Georgebruh/Vantage-System-for-ANDAM/outputs/power-board/Vantage_Power_Envelope.pdf

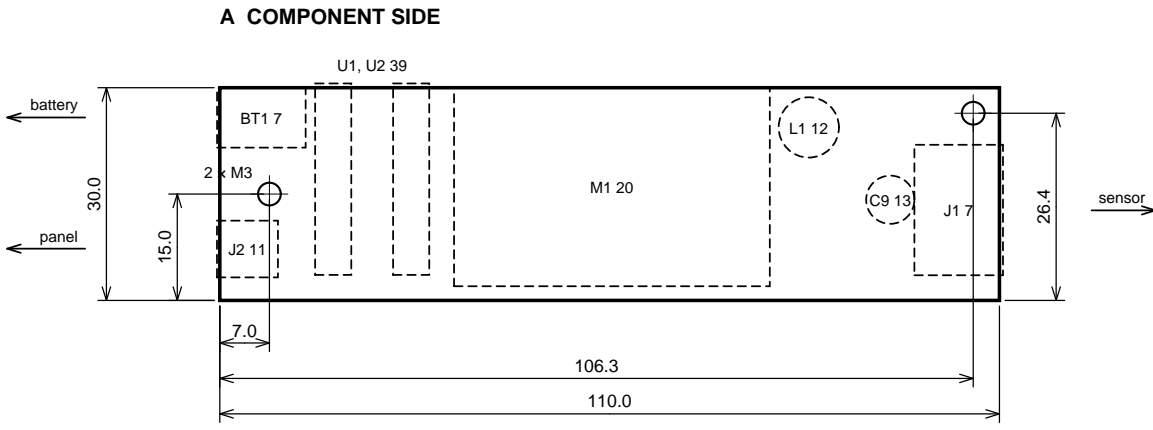
[picture p1: figure]
A COMPONENT SIDE; battery; panel; sensor

C END VIEW, SMALLEST ROUND TUBE

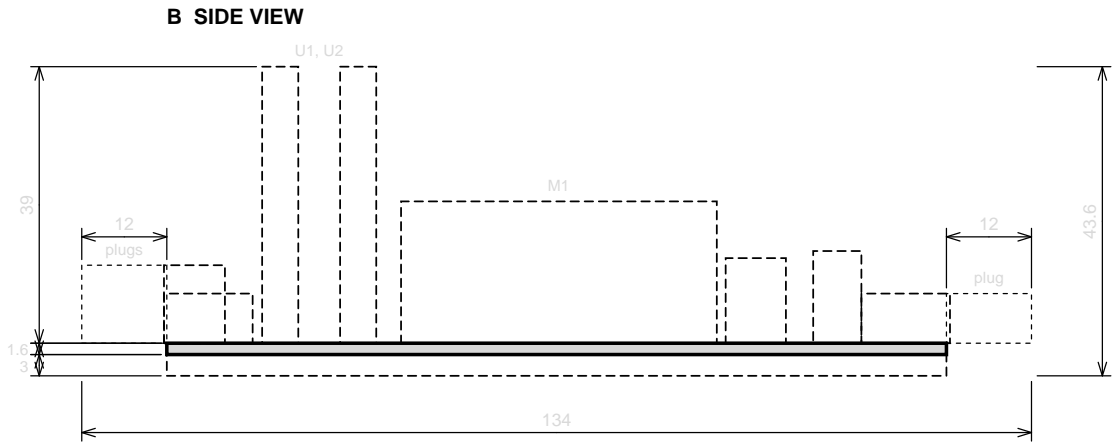
[picture p2: figure]
B SIDE VIEW; plug; plugs

Dimensions in millimetres. Heights are above the board, for the parts listed in VNT-002. Board 110 × 30 × 1.6 mm, same outline and M3 hole pattern as the sensor board. Envelope 134 × 30 × 43.6 mm with 12 mm at each end for the plugs.
A round tube needs an inner diameter of at least 53 mm; allow 2 mm more.
Battery lead and panel wires leave at the left end, the sensor cable at the right end. U1, U2: INA226 module standing in an 8.5 mm socket; 39 mm covers a 27 mm module. M1: CN3791 module on 8.5 mm sockets, within 44 × 28 mm.

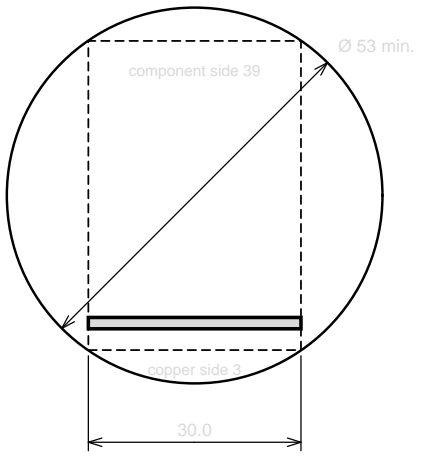
[picture p3: figure]
component side 39; copper side 3; Ø 53 min.

### Team sevenUP

Vantage — Power board, module envelope

Date 2026-11-05 | Rev B 1:1
