Georgebruh/Vantage-System-for-ANDAM/outputs/power-board/Vantage_Power_Assembly-Drawing.pdf

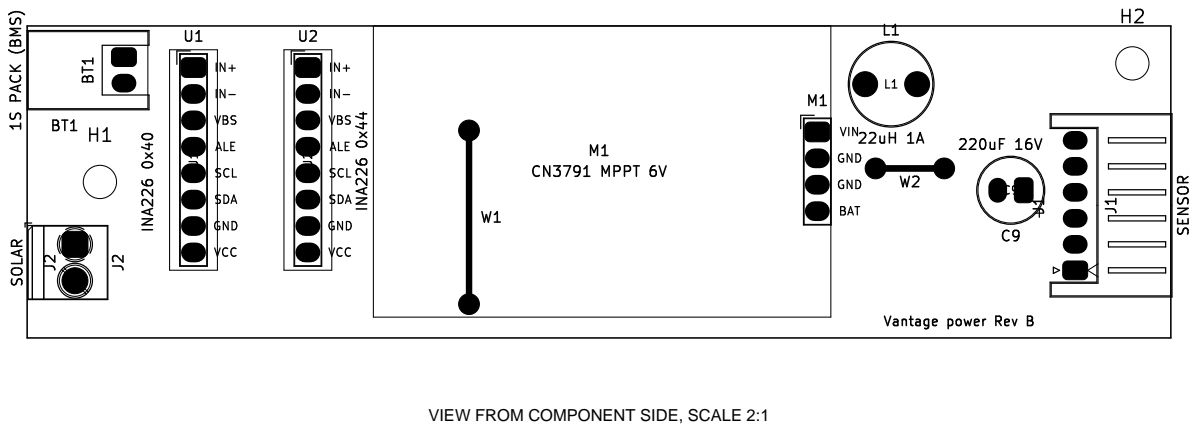
[picture p10: page 1]

VIEW FROM COMPONENT SIDE, SCALE 2:1

File: Vantage_Power.kicad_pcb Sheet: Team sevenUP

Id: 1/1 Title: Vantage þÿ Power board

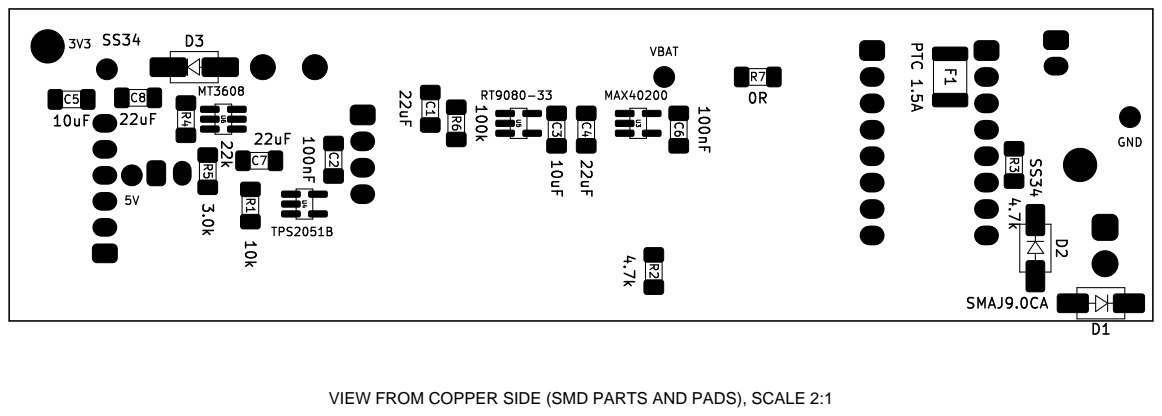
[picture p11: page 2]

File: Vantage_Power.kicad_pcb Sheet: Team sevenUP ²²k R4

VIEW FROM COPPER SIDE (SMD PARTS AND PADS), SCALE 2:1

Id: 1/1 Title: Vantage þÿ Power board
