Georgebruh/Vantage-System-for-ANDAM/outputs/power-board/Vantage_Power_Copper-Artwork_A4.pdf

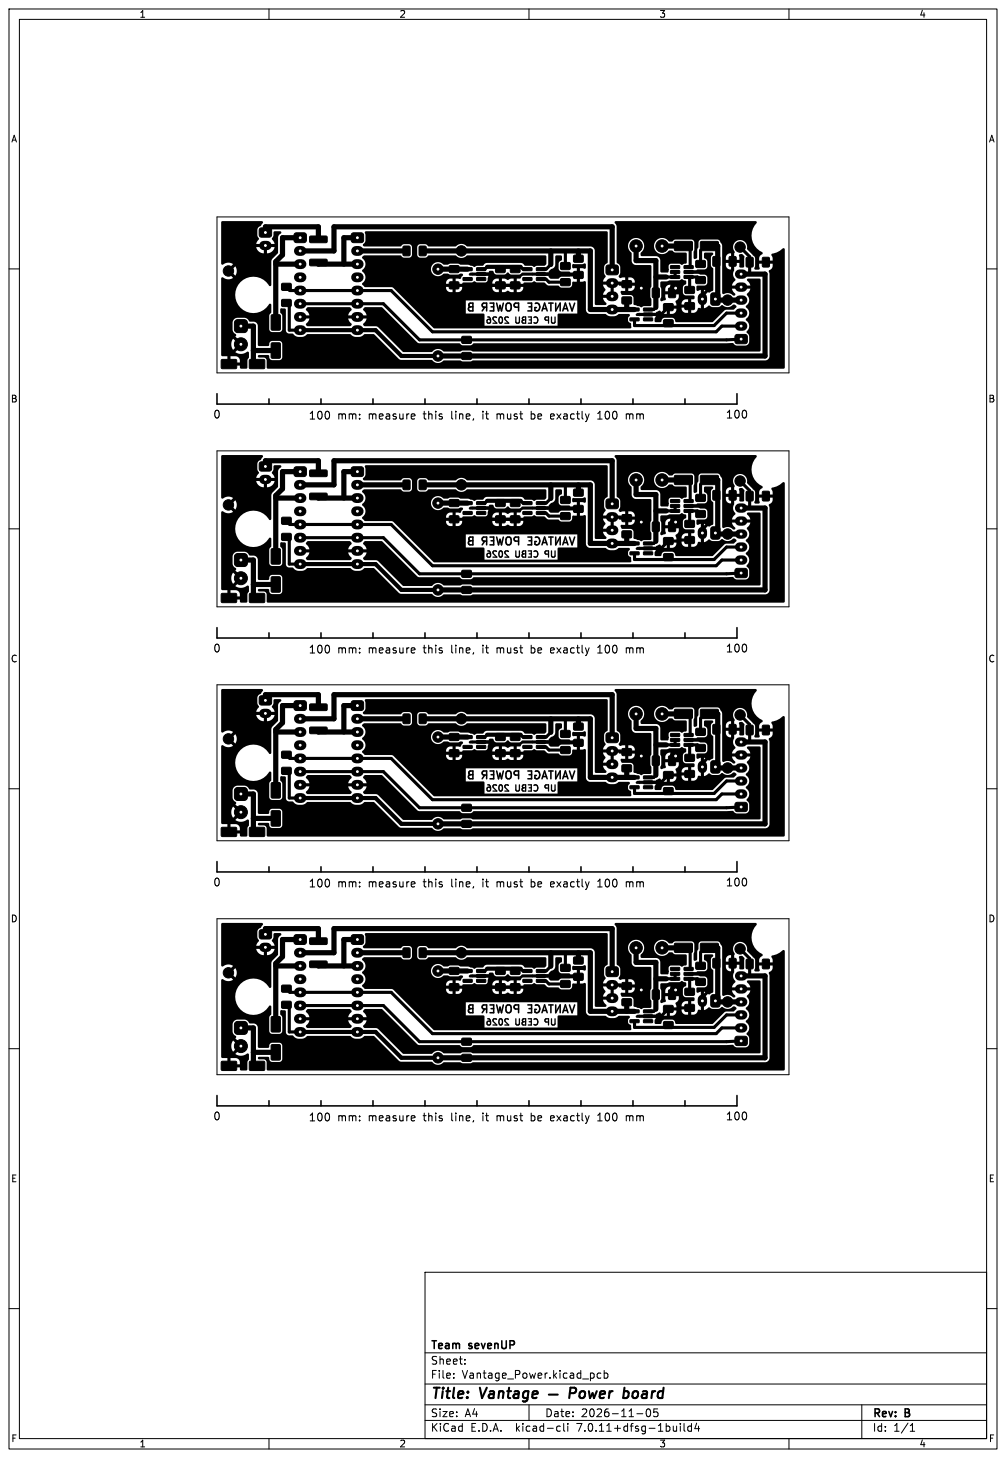
[picture p13: page 1]
F Date: 2026-11-05 KiCad; kicad-cli; 7.0.11+dfsg-1build4 Size: A4; Rev:

File: Vantage_Power.kicad_pcb Sheet: Team sevenUP

Id: 1/1 Title: Vantage þÿ Power board
