Georgebruh/Vantage-System-for-ANDAM/outputs/power-board/Vantage_Power_Copper-Artwork_Letter.pdf

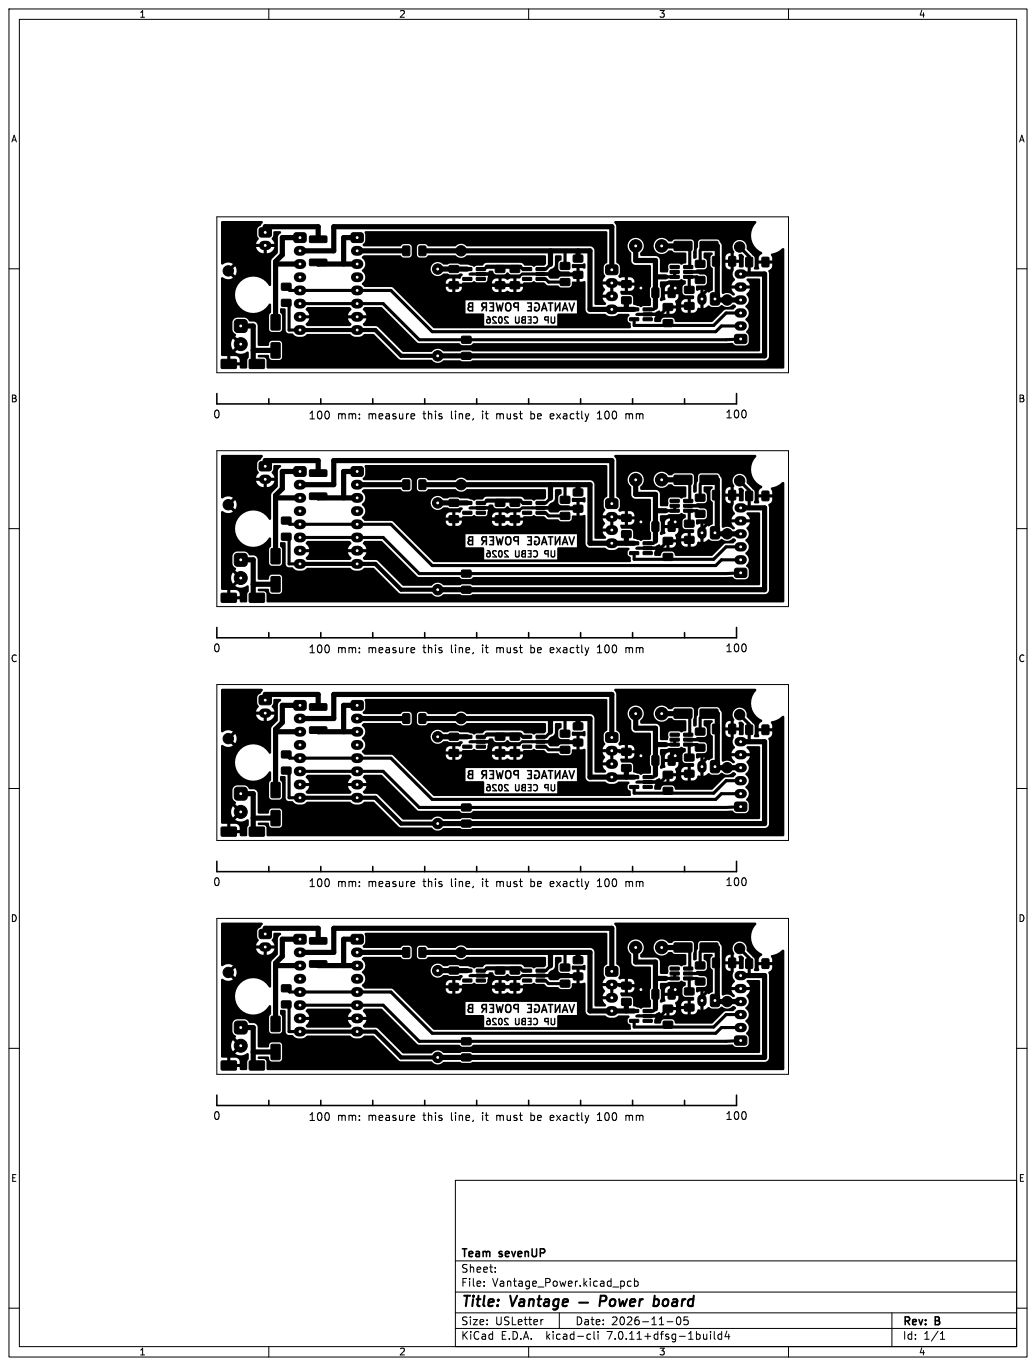
[picture p14: page 1]
E Date: 2026-11-05 KiCad; kicad-cli; 7.0.11+dfsg-1build4 Size: USLetter; Rev:

File: Vantage_Power.kicad_pcb Sheet: Team sevenUP

Id: 1/1 Title: Vantage þÿ Power board
