Georgebruh/Vantage-System-for-ANDAM/power-board/Vantage_Power.kicad_pcb

## KiCad design power-board/Vantage_Power.kicad_pcb (2026-11-06)

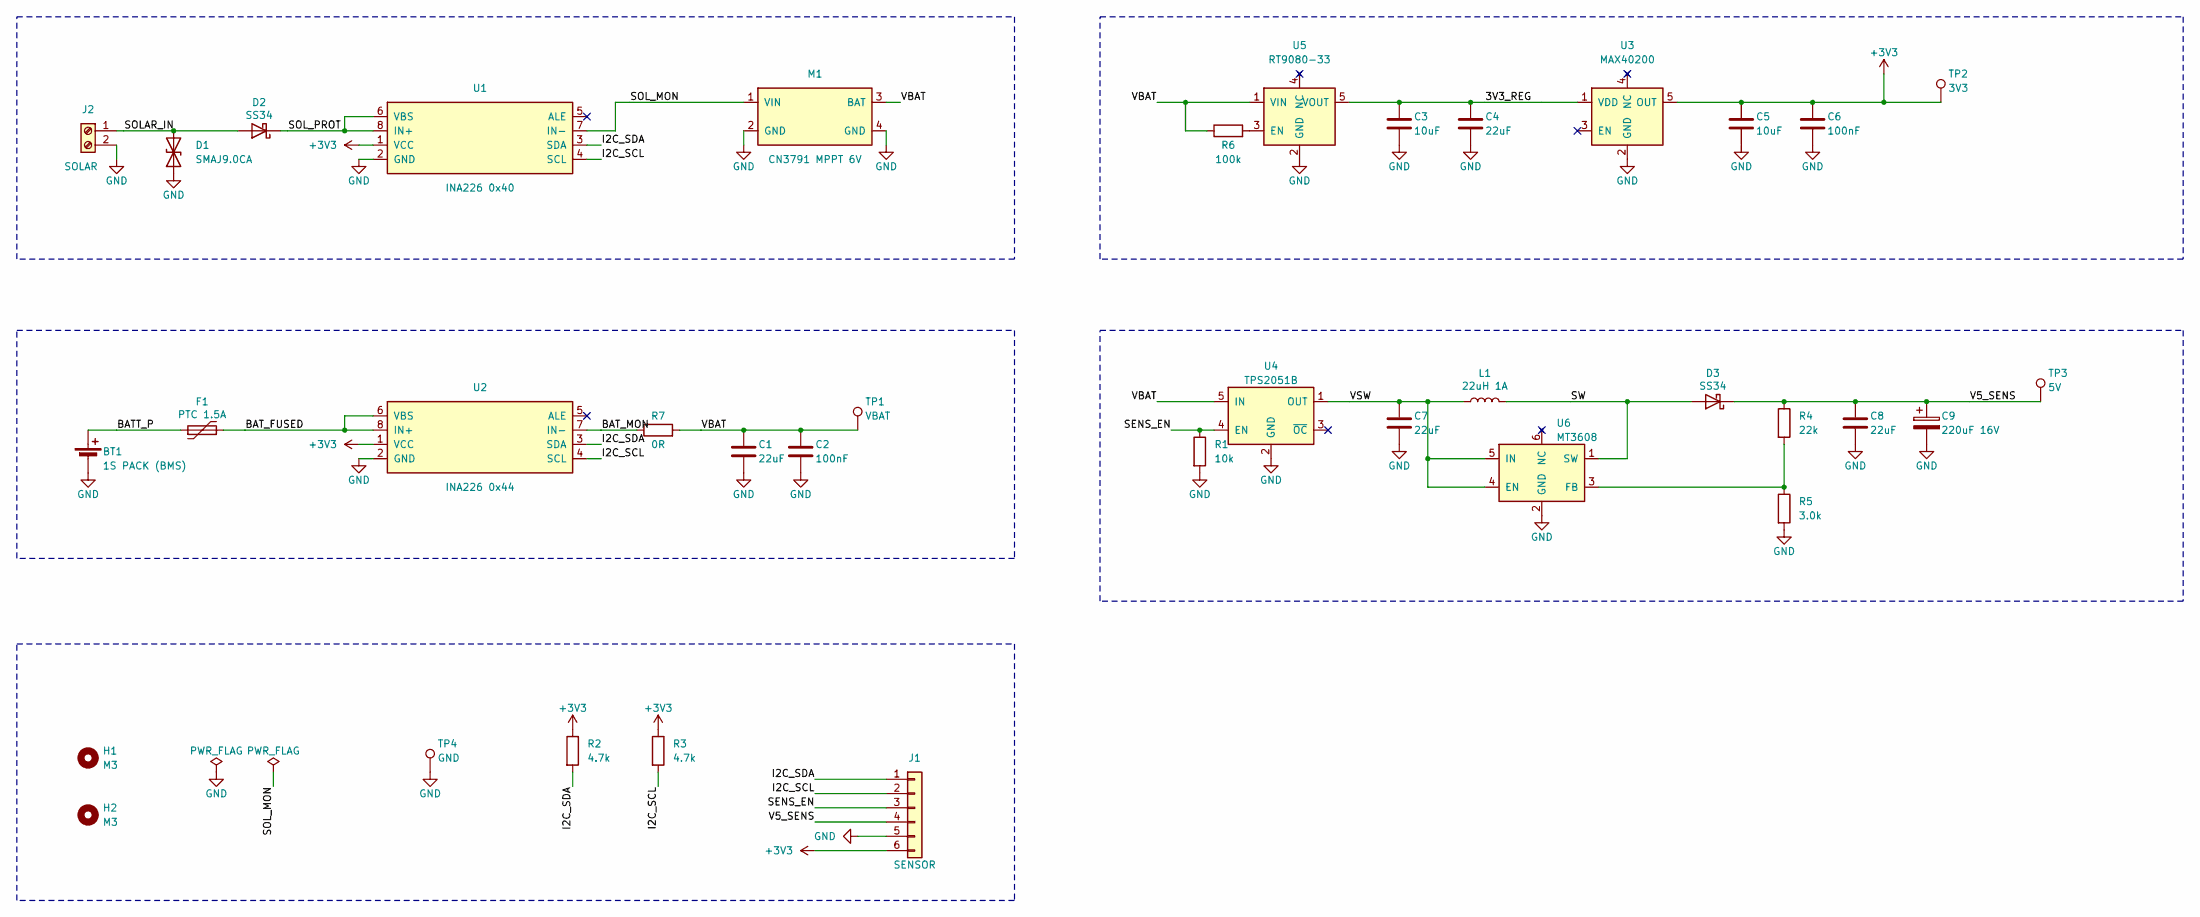
[picture p15: schematic Vantage_Power.kicad_sch, Vantage — Power board]

Parts:
BT1: 1S PACK (BMS); JST_XH_S2B-XH-A_1x02_P2.50mm_Horizontal_Toner
C1, C4, C7, C8: 22uF; C_1206_HandSolder_Bottom
C2, C6: 100nF; C_1206_HandSolder_Bottom
C3, C5: 10uF; C_1206_HandSolder_Bottom
C9: 220uF 16V; CP_Radial_D6.3mm_P2.50mm_Toner
D1: SMAJ9.0CA; D_SMA_HandSolder_Bottom_WideGap
D2: SS34; D_SMA_HandSolder_Bottom_WideGap
D3: SS34; D_SMA_HandSolder_Bottom
F1: PTC 1.5A; Fuse_1812_HandSolder_Bottom
H1, H2: M3; MountingHole_3.2mm_M3_KeepCopper3.5mm
J1: SENSOR; JST_XH_S6B-XH-A_1x06_P2.50mm_Horizontal_Toner
J2: SOLAR; TerminalBlock_3.5mm_1x02_Toner
L1: 22uH 1A; L_Radial_D8.0mm_P5.00mm_Toner
M1: CN3791 MPPT 6V; CN3791_Socket_1x04
R1: 10k; R_1206_HandSolder_Bottom
R2, R3: 4.7k; R_1206_HandSolder_Bottom
R4: 22k; R_1206_HandSolder_Bottom
R5: 3.0k; R_1206_HandSolder_Bottom
R6: 100k; R_1206_HandSolder_Bottom
R7: 0R; R_1206_HandSolder_Bottom
TP1: VBAT; TestPoint_Pad_D2.0mm_Bottom
TP2: 3V3; TestPoint_Pad_D2.0mm_Bottom
TP3: 5V; TestPoint_Pad_D2.0mm_Bottom
TP4: GND; TestPoint_Pad_D2.0mm_Bottom
U1: INA226 0x40; INA226_Socket_1x08_Upright
U2: INA226 0x44; INA226_Socket_1x08_Upright
U3: MAX40200; SOT-23-5_HandSolder_Bottom
U4: TPS2051B; SOT-23-5_HandSolder_Bottom
U5: RT9080-33; SOT-23-5_HandSolder_Bottom
U6: MT3608; SOT-23-6_HandSolder_Bottom

Connections:
+3V3: C5.1, C6.1, J1.6, R2.1, R3.1, TP2.1, U1.1 (VCC), U2.1 (VCC), U3.5 (OUT)
/3V3_REG: C3.1, C4.1, U3.1 (VDD), U5.5 (VOUT)
/BATT_P: BT1.1 (+), F1.1
/BAT_FUSED: F1.2, U2.6 (VBS), U2.8 (IN+)
/BAT_MON: R7.1, U2.7 (IN-)
/I2C_SCL: J1.2, R3.2, U1.4 (SCL), U2.4 (SCL)
/I2C_SDA: J1.1, R2.2, U1.3 (SDA), U2.3 (SDA)
/SENS_EN: J1.3, R1.1, U4.4 (EN)
/SOLAR_IN: D1.2 (A2), D2.2 (A), J2.1
/SOL_MON: M1.1 (VIN), U1.7 (IN-)
/SOL_PROT: D2.1 (K), U1.6 (VBS), U1.8 (IN+)
/SW: D3.2 (A), L1.2, U6.1 (SW)
/V5_SENS: C8.1, C9.1, D3.1 (K), J1.4, R4.1, TP3.1
/VBAT: C1.1, C2.1, M1.3 (BAT), R6.1, R7.2, TP1.1, U4.5 (IN), U5.1 (VIN)
/VSW: C7.1, L1.1, U4.1 (OUT), U6.4 (EN), U6.5 (IN)
GND: BT1.2 (-), C1.2, C2.2, C3.2, C4.2, C5.2, C6.2, C7.2, C8.2, C9.2, D1.1 (A1), J1.5, J2.2, M1.2 (GND), M1.4 (GND), R1.2, R5.2, TP4.1, U1.2 (GND), U2.2 (GND), U3.2 (GND), U4.2 (GND), U5.2 (GND), U6.2 (GND)
unnamed: R6.2, U5.3 (EN)
unnamed: R4.2, R5.1, U6.3 (FB)

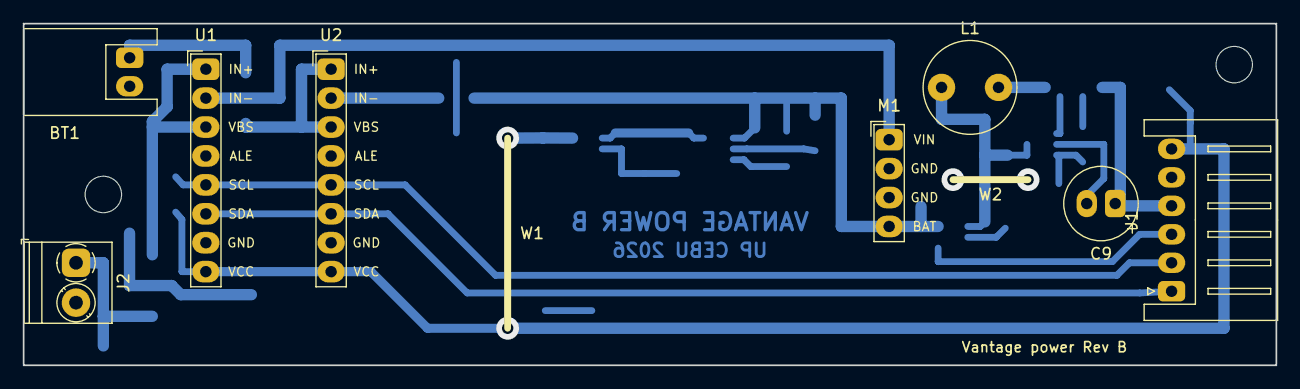
[picture p16: board Vantage_Power.kicad_pcb from above]

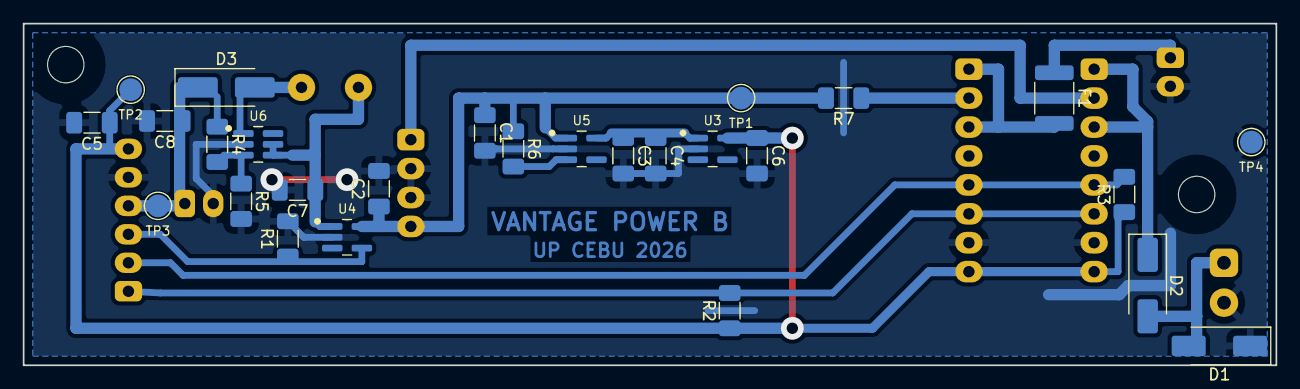
[picture p17: board Vantage_Power.kicad_pcb from below]

Board: 2 copper layers, 110.0 x 30.0 mm, 37 parts (27 on the bottom side), 18 nets.
